dobleuber/strix/stl/spacer.stl

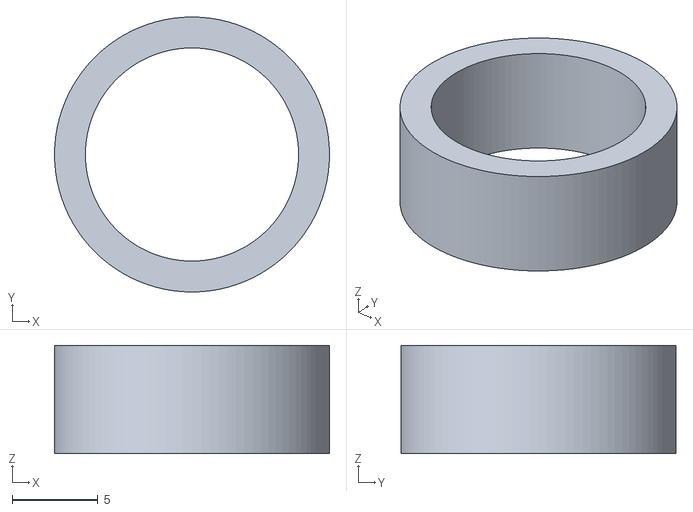
[picture p8: CAD file, 2026-11-14]
stl/spacer.stl
16.0 x 16.0 x 6.30
