dobleuber/strix/stl/turntable_cover.stl

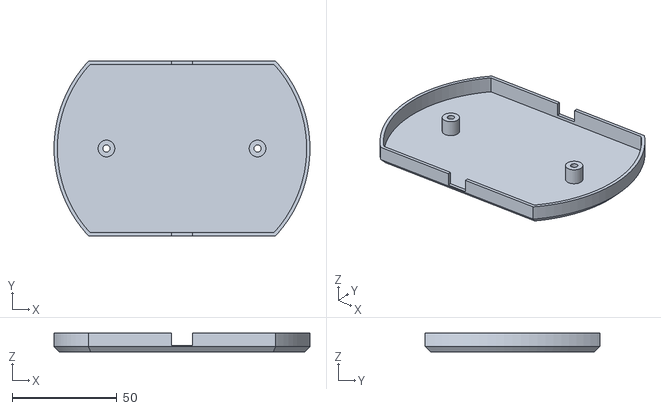
[picture p9: CAD file, 2026-11-14]
stl/turntable_cover.stl
122.0 x 83.2 x 9.00
