dobleuber/strix/stl/head_rear.stl

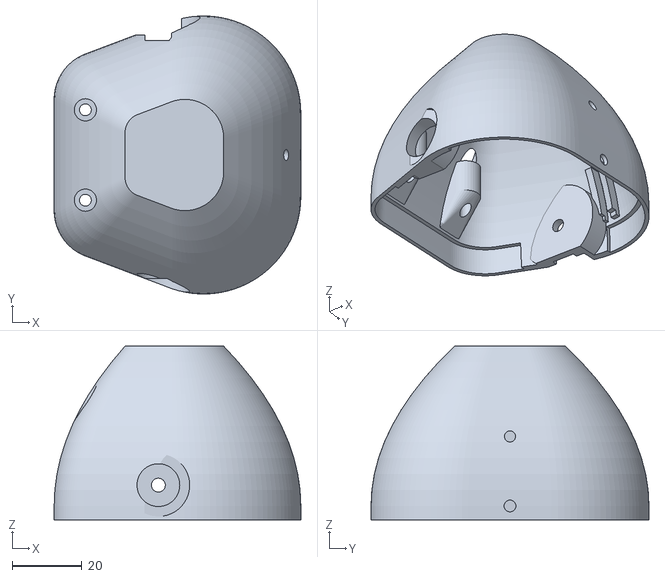
[picture p10: CAD file, 2026-11-14]
stl/head_rear.stl
71.0 x 80.0 x 50.0
