dobleuber/strix/stl/cover_idle.stl

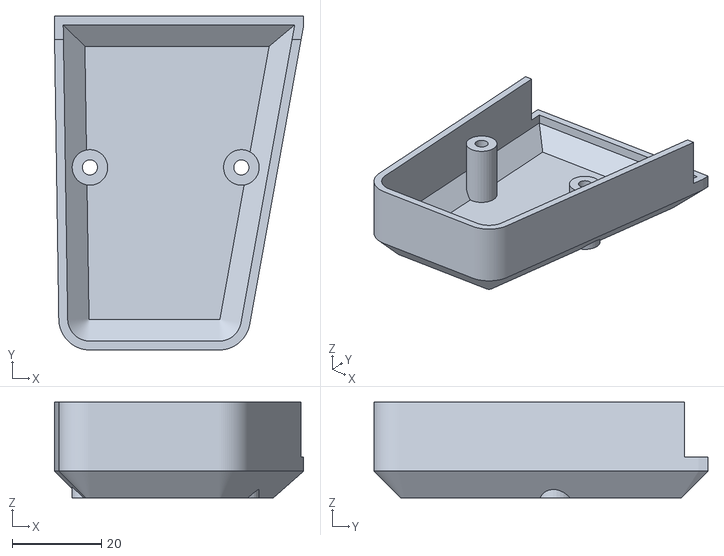
[picture p11: CAD file, 2026-11-14]
stl/cover_idle.stl
56.0 x 75.0 x 21.5
