dobleuber/strix/stl/trunnion.stl

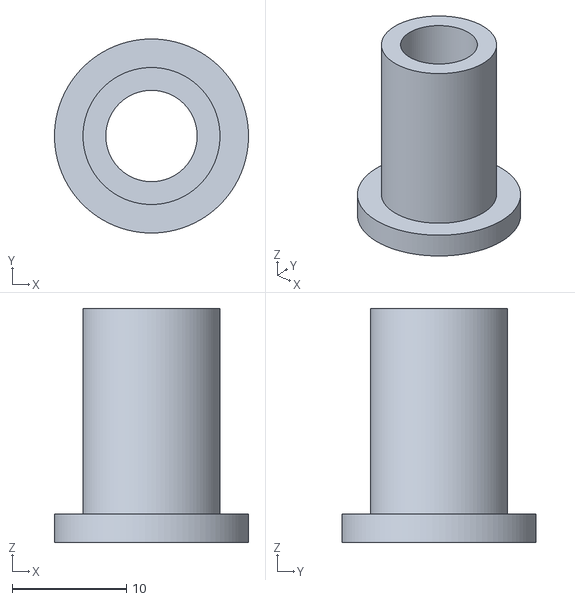
[picture p12: CAD file, 2026-11-14]
stl/trunnion.stl
17.0 x 17.0 x 20.5
