dobleuber/strix/stl/arm_servo.stl

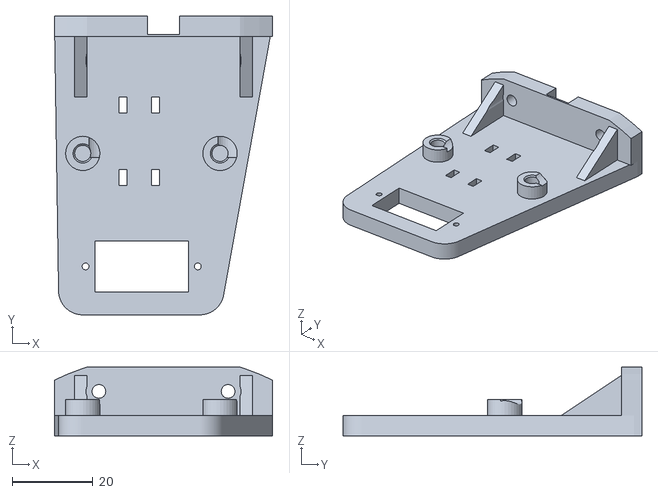
[picture p13: CAD file, 2026-11-14]
stl/arm_servo.stl
54.0 x 74.0 x 17.0
