dobleuber/strix/stl/turntable.stl

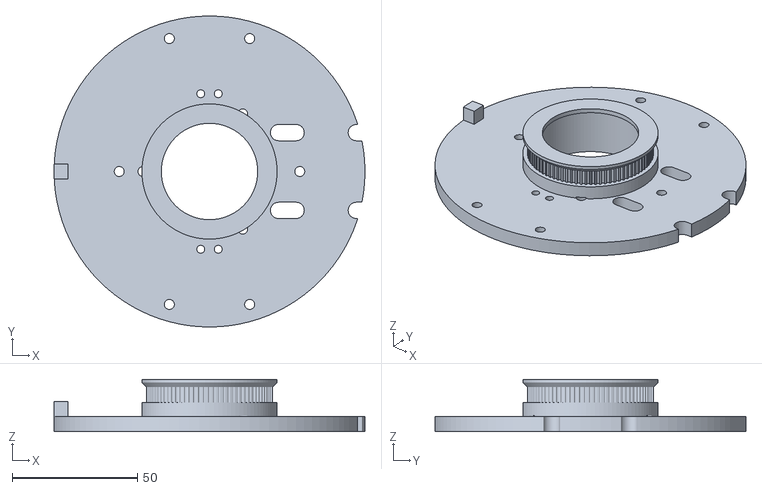
[picture p14: CAD file, 2026-11-14]
stl/turntable.stl
124.0 x 124.0 x 20.8
