dobleuber/strix/stl/plate.stl

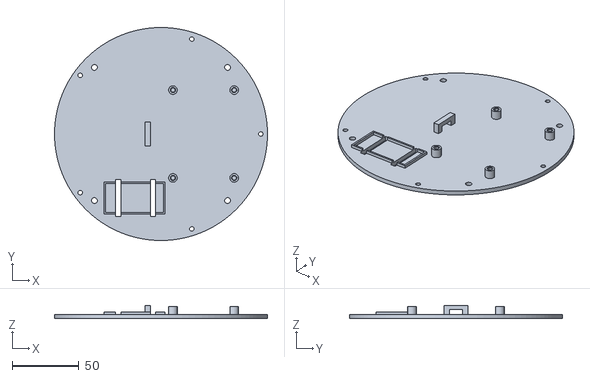
[picture p15: CAD file, 2026-11-14]
stl/plate.stl
160.0 x 160.0 x 10.0
