dobleuber/strix/stl/iris.stl

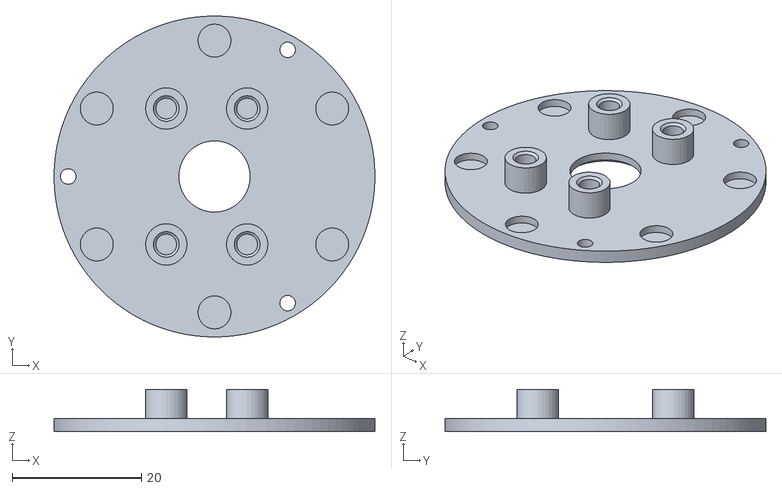
[picture p16: CAD file, 2026-11-13]
stl/iris.stl
49.6 x 49.6 x 6.50
