dobleuber/strix/stl/deck.stl

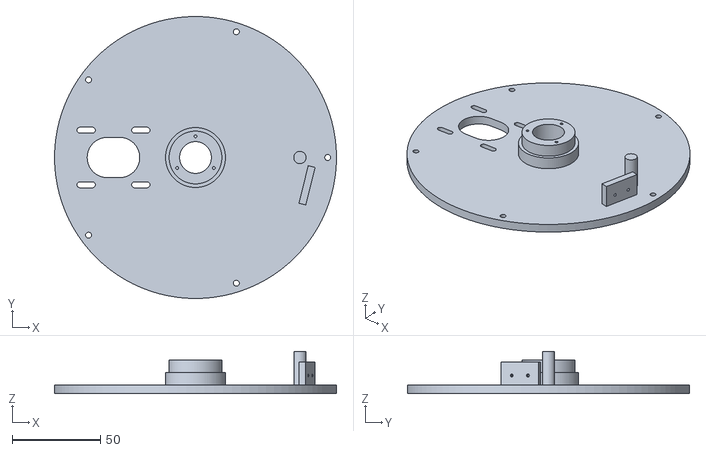
[picture p17: CAD file, 2026-11-13]
stl/deck.stl
160.0 x 160.0 x 24.0
