dobleuber/strix/stl/gauge.stl

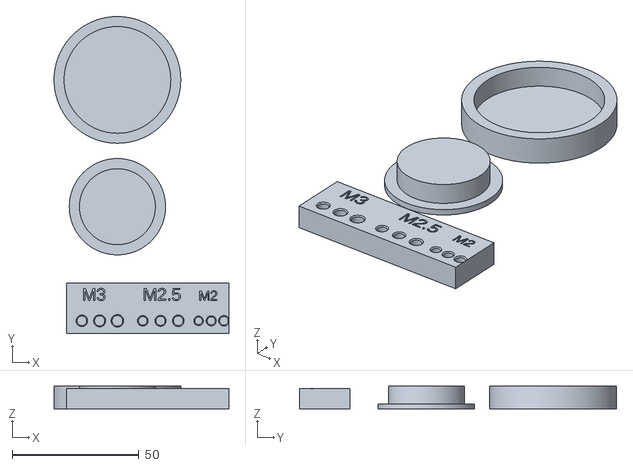
[picture p18: CAD file, 2026-11-13]
stl/gauge.stl
69.0 x 125.0 x 9.00
