dobleuber/strix/stl/sled.stl

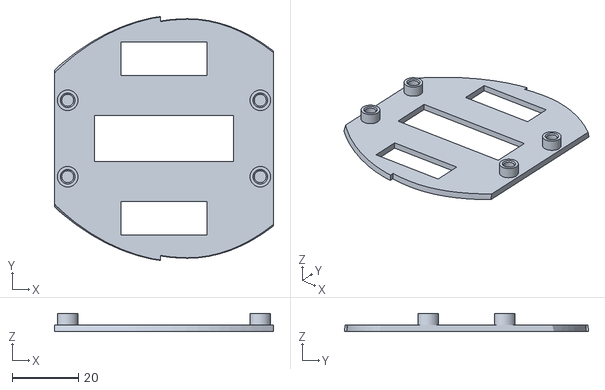
[picture p19: CAD file, 2026-11-13]
stl/sled.stl
66.0 x 73.5 x 5.50
