dobleuber/strix/stl/shell.stl

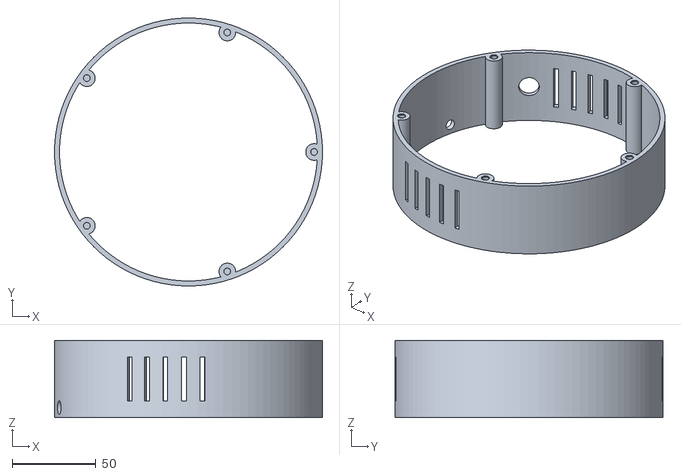
[picture p20: CAD file, 2026-11-13]
stl/shell.stl
160.0 x 160.0 x 46.0
