dobleuber/strix/stl/head_front.stl

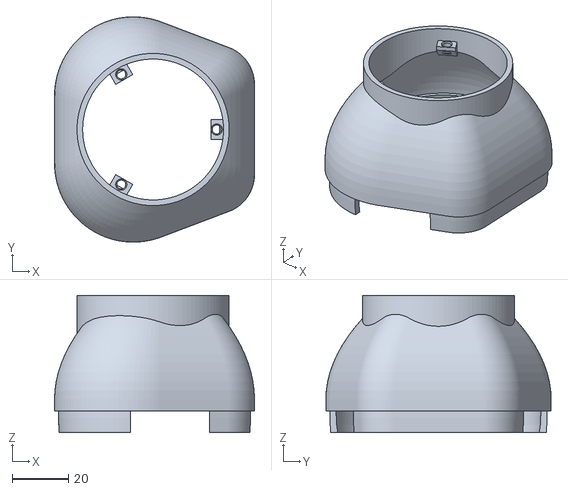
[picture p21: CAD file, 2026-11-13]
stl/head_front.stl
71.0 x 80.0 x 48.7
