dobleuber/strix/stl/ring.stl

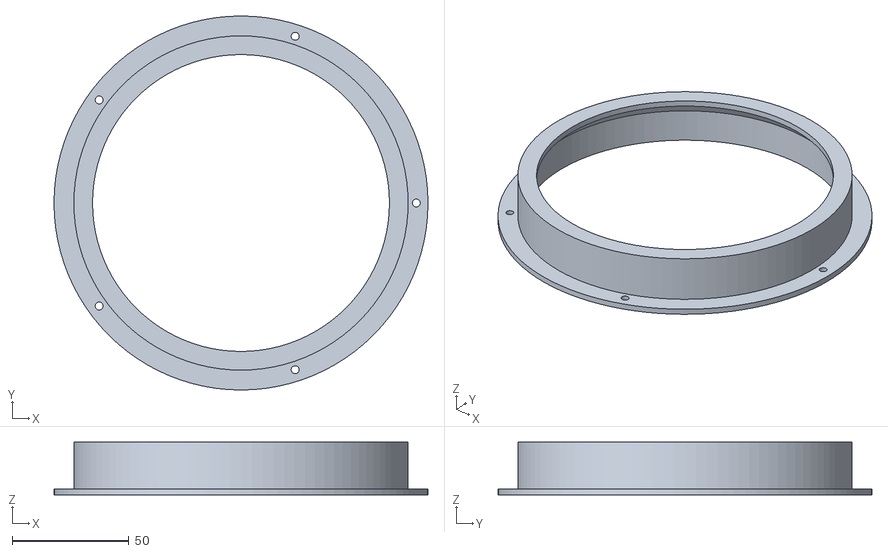
[picture p22: CAD file, 2026-11-13]
stl/ring.stl
160.0 x 160.0 x 22.5
