dobleuber/strix/stl/cap.stl

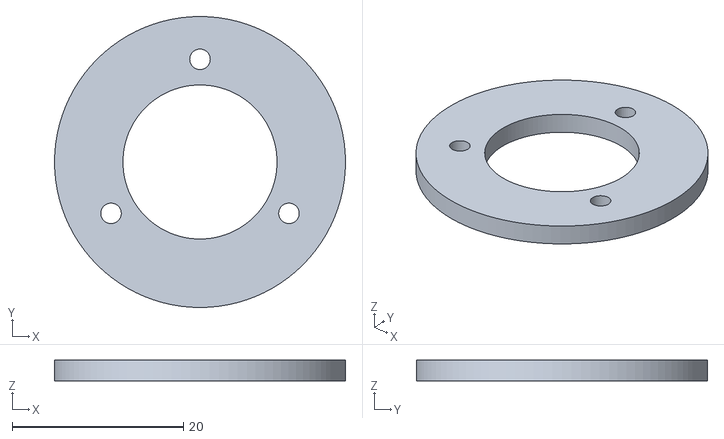
[picture p23: CAD file, 2026-11-13]
stl/cap.stl
34.0 x 34.0 x 2.40
