dobleuber/strix/stl/port_plug.stl

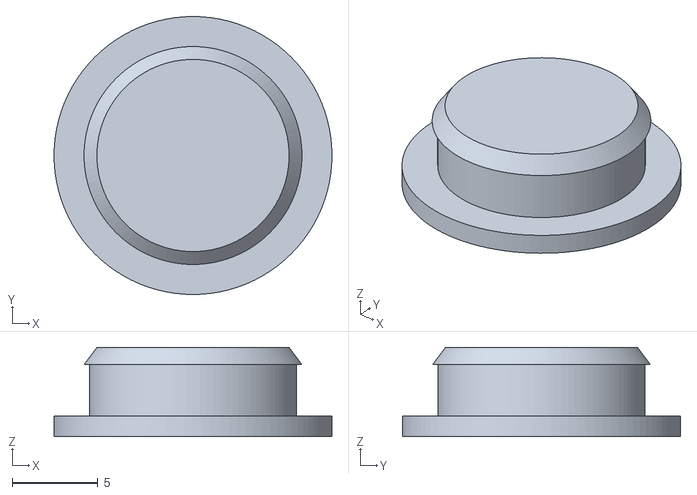
[picture p24: CAD file, 2026-11-13]
stl/port_plug.stl
16.2 x 16.2 x 5.20
