dobleuber/strix/stl/bezel.stl

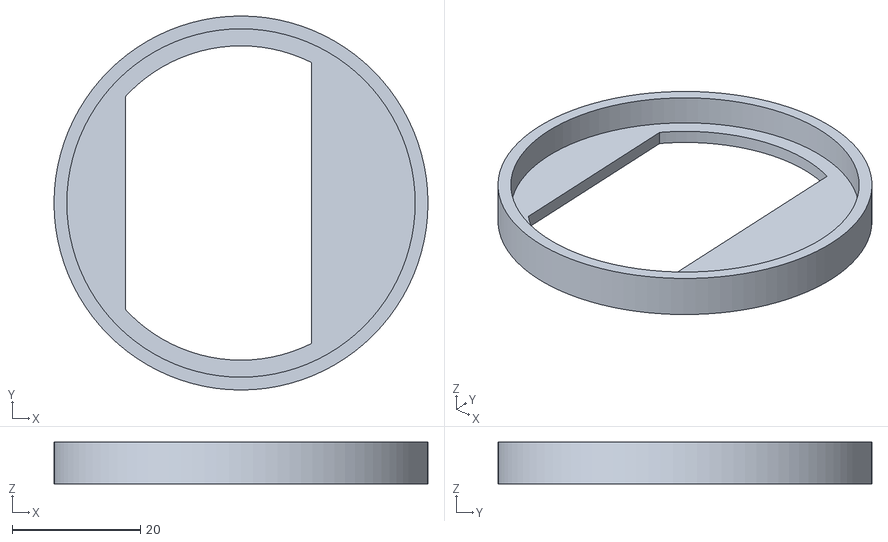
[picture p25: CAD file, 2026-11-13]
stl/bezel.stl
58.3 x 58.3 x 6.50
