dobleuber/strix/stl/retainer.stl

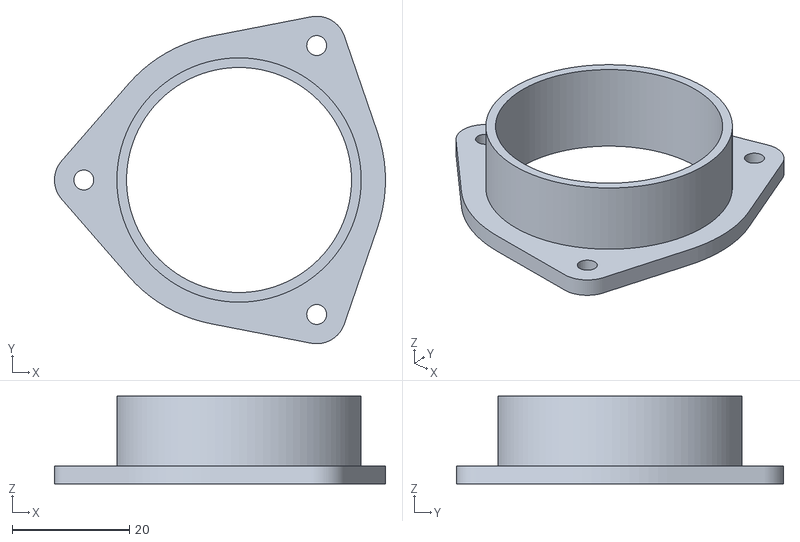
[picture p26: CAD file, 2026-11-13]
stl/retainer.stl
56.5 x 55.9 x 15.0
