dobleuber/strix/(list of files, cad)

Other CAD files:
stl/cover_servo.stl
stl/arm_idle.stl
