dobleuber/strix/(commit log)

2026-11-12 Add Strix v0.1 concept model
    Parametric OpenSCAD layout model of a desktop turret robot: fixed base,
    belt-driven pan, tilting cradle, sensor or launcher head, and an optional
    rail module. Includes renders and a README.
    Claude-Session: https://claude.ai/code/session_01UhhE4AyNSV4cwT1wmxKGh3
    [strix-v0.1.scad]
2026-11-12 Adopt the cyclops head and move the brain into it
    The head is now a one-eyed cyclops (camera as pupil, shutters, antenna),
    with a sensor version and a launcher version. The Raspberry Pi Zero 2 and
    its CSI camera sit in the head; a Raspberry Pi Pico in the base drives the
    steppers. The earlier head studies stay selectable through head_style.
    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
    [strix-v0.1.scad]
2026-11-12 Round the cyclops head into a pod
    The head is no longer a faceted box: it is a hull of elliptical sections,
    with the eye mounted on a short barrel. The launcher version is a longer
    pod with a flatter belly so the flywheels still fit.
    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
    [strix-v0.1.scad]
2026-11-13 Add printable phase 1 parts with heat-set inserts
    cad/strix-print.scad models the base, pan stage, yoke and the cyclops
    sensor head as 16 printable parts plus a fit gauge, with insert holes for
    every fastened component, a hard stop and homing switch for the pan axis,
    and a two-piece head that prints without supports. STLs are exported in
    print pose under stl/ by scripts/export-stl.sh.
    All parts export as single manifold bodies and the assembly has no
    interference at tilt -15, 0 and +35 degrees. Nothing has been printed yet.
    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
    [arm_idle.stl, arm_servo.stl, bezel.stl, cap.stl, deck.stl, gauge.stl, head_front.stl, head_rear.stl]
2026-11-13 Add a dynamics script and an as-built export mode
    sim/dynamics.py integrates mass, centre of mass and inertia over the
    printable meshes, adds the bought components as point masses, and reports
    the pan and tilt margins. cad/strix-print.scad gains as_built=true to emit
    a part where it sits in the assembly instead of in its print pose.
    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
    [strix-print.scad]
2026-11-14 Design the wiring between head, turntable and base
    Add cable anchors to the printable parts (a strain-relief rib in the head,
    tie slots down the servo arm, tie holes in the turntable, a tie bar on the
    plate), draw the two wiring runs in the assembly, and document the wiring
    diagram, runs and proposed pinout in the README.
    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
    [arm_servo.stl, head_rear.stl, plate.stl, strix-print.scad, turntable.stl]
2026-11-14 Hide the wiring: hollow tilt trunnion and three covers
    The head harness now leaves through a hollow trunnion on the tilt axis
    instead of hanging under the head, and both runs reach the pan axis through
    a channel under each arm. An arm cover on each side and a low turntable
    cover hide the servo, the leads and the connector. The idle arm turns on
    the trunnion, so the 623 bearing and the axle screw are gone.
    All parts export as valid single bodies and the assembly has no
    interference with the covers on at tilt -15, 0, 20 and 35 degrees.
    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
    [arm_idle.stl, arm_servo.stl, cover_idle.stl, cover_servo.stl, head_rear.stl, spacer.stl, strix-print.scad, trunnion.stl]
